eSpark-Backup/stephenlong-acfoutputpcb/README.md

# ACF Output PCB
####  Client Name: Stephen Long Jr.

## Project Requirements
This project involves the PCB layout design for the ACF Output PCBA, a daughter board of the ACF system. The Output PCBA serves as the main I/O interface for DMX and Ethernet signals and includes electrical connections to the system’s external circular connector and a board-to-board interface with the ACF User Interface PCBA via a Bridge PCBA. The core features and selected parts information is mentioned below:
- Connectors
    - DMX Input Connector:
        - Part Number: NC5MBV-B (5-pin male XLR)
    - DMX Output Connector:
        - Part Number: NC5FBV-B (5-pin female XLR)
    - DMX input/output circuitry
        - Add the SM712 very close to the "outside world" connector for the DMX. It is a very basic TVS protection in case the customer would connect a wrong cable to the line. This TVS will protect the electronics. I think it is the best place for the protections.


- Ethernet Connectors x 2
    - Part Number: NE8FBV-C5-LED (EtherCON RJ45 receptacles with integrated light pipes)
        - Please add those resistors and capacitors next to the ethernet connectors.
        - And also add a TVS protection on each RS485 differential pair, we usually use the SM712
        - Reference design for Ethernet and TVS Datasheet is pushed to docs (to be considered as a suggestion and reference only)
- Board to Board Data x 2
    - Part Number: SSW-110-02-G-D-RA-N Mfr.: Samtec
    - User Interface PCBA for reference:  

- LED Indicators for Ethernet
    - Each RJ45 port requires:
        - Left LED (Green): Indicates active link
        - Right LED (Yellow): Indicates data activity
    - LEDs will be SMD-mounted under the NE8FBV-C5-LED light pipe window.
        - Placement and routing shall follow manufacturer light pipe guidelines.
- Board-to-Board Interface (to Bridge PCBA)
    - Include a board-to-board header to connect with the Bridge PCBA.

- Circular Connector Output Header
    - 8-pin output header for external panel connection:
        - 2x 24V lines (14AWG)
        - 2x GND (14AWG)
        - 4x differential data pair (twisted pair) to panels (26AWG) (total of 8 wires)
        - 8A current capacity for power lines  
  
    - Pinout and mechanical dimensions will be confirmed during layout phase
### Pin Number Reference Photos






**Note:** The new LEDs coming from the W5500 and the "GND_DRIVE" will be the signals for driving the LEDs on the ethernet connections. They are pins 4-5-6 on the J10 connectors. Also mention that the P1LED and P2LED should drive via the "GND_DRIVE" pin (one side to PxLED an the other to "GND_DRIVE".

### Assumptions and Constraints
- The ACF Output PCBA will not contain any microcontrollers or active control logic; it is a passive I/O board.
- All firmware, control logic, and display interfacing is handled by the ACF UI PCBA.
- Mechanical constraints must be confirmed early in the layout process to ensure connector alignment and clearance

### Product Concept Images
