eSpark-Backup/stephenlong-acfoutputpcb/Design-Files/ACF_Out-v2.0/Deliverables/_Renderings/2D_C_View.png

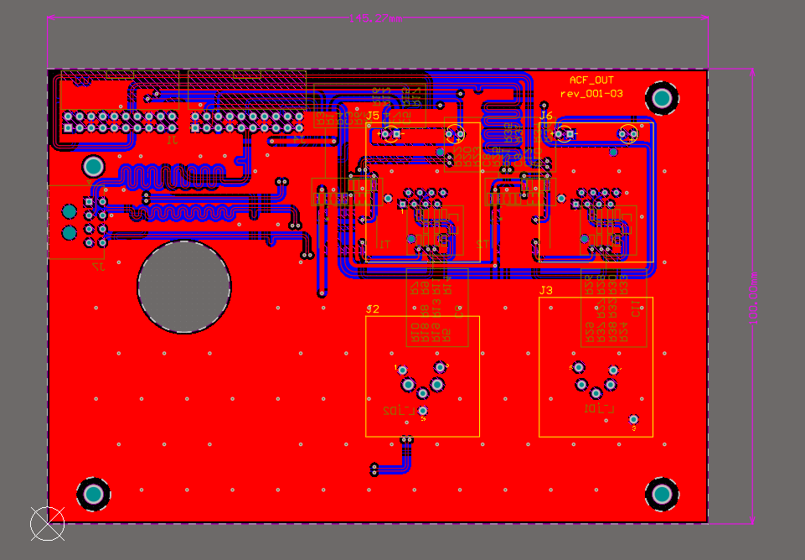
Design-Files/ACF_Out-v2.0/Deliverables/_Renderings/2D_C_View.png
