eSpark-Backup/stephenlong-acfoutputpcb/Design-Files/ACF_Out-v2.0/Deliverables/_Renderings/3D_Isometric_View.png

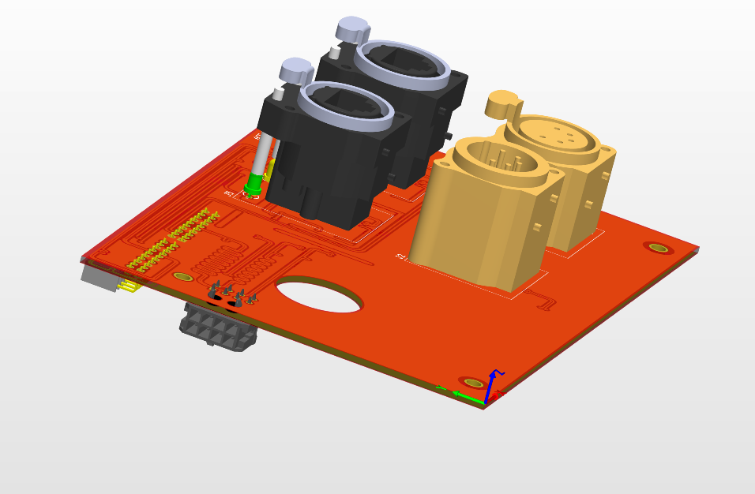
Design-Files/ACF_Out-v2.0/Deliverables/_Renderings/3D_Isometric_View.png
