eSpark-Backup/stephenlong-acfoutputpcb/docs/Client-Files/Reference Materials/Ethernet Reference Schematic.png

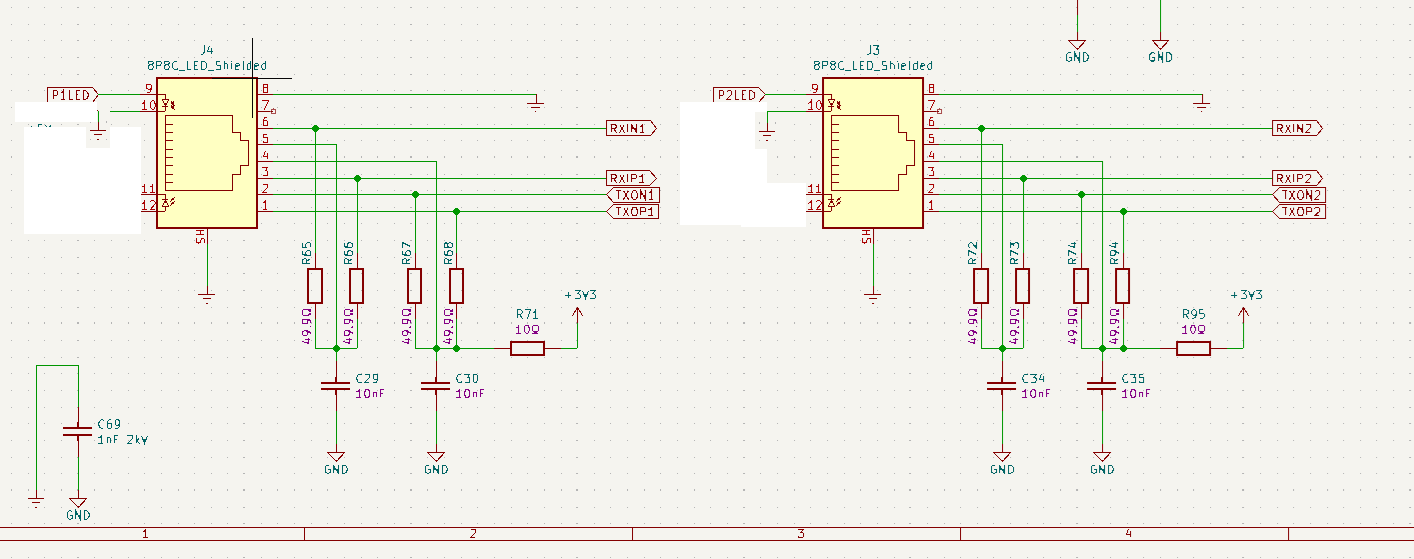
docs/Client-Files/Reference Materials/Ethernet Reference Schematic.png
