eSpark-Backup/stephenlong-acfoutputpcb/Design-Files/ACF_Out-v2.0/Deliverables/_BOM/Client_BOM_ACF_Out-v2.0.xlsx

# | Item Type | Designator | Description | Footprint | Manufacturer Part Number | Manufacturer | Comment | Quantity
1 | Capacitor | C3, C8 | CAP CER 0.022UF 50V X7R 0603 | Cap-0603 | CC0603KRX7R9BB223 | Yageo | 22nF | 2
2 | Capacitor | C4, C5, C9, C10 | 50V 6.8nF X7R ±10% 0603 | Cap-0603 | 0603B682K500NT | FH | 6.8nF | 4
3 | Capacitor | C6, C11 | CAP CER 4700PF 1KV X7R 1206 | Cap-1206 | CC1206KKX7RCBB472 | Yageo | 4.7nF | 2
4 | Capacitor | C7, C12 | CAP CER 10000PF 100V X7R 0603 | Cap-0603 | CC0603KRX7R0BB103 | Yageo | 10nF | 2
5 | Diode | D1, D2 | SOT-23 TVS ROHS | SOT-23 | SM712 | TECH PUBLIC | SM712 | 2
6 | Connectors | J1, J4 | CONN RCPT 20POS 0.1 GOLD PCB R/A | SSW-110-02-G-D-RA-N | SSW-110-02-G-D-RA-N | Samtec | SSW-110-02-G-D-RA-N | 2
7 | Audio / Video Connectors | J2 | XLR Connectors 5P M RECEPT B SER PCBV PN 1 GRD SEP BK | NC5MBV-B | NC5MBV-B | Neutrik | NC5MBV-B | 1
8 | Connectors | J3 | XLR Connectors 5P M RECEPT B SER PCBV PN 1 GRD SEP BK | NC5FBV-B | NC5FBV-B | Neutrik | NC5FBV-B | 1
9 | Modular / Ethernet Connectors | J5, J6 | Modular Connectors / Ethernet Connectors RECP CAT5e B series PCBV, 24mm FP to PCB | NE8FBV-C5-LED | NE8FBV-C5-LED | Neutrik | NE8FBV-C5-LED | 2
10 | Headers and Wire Housings | J7 | CONN HEADER R/A 8POS 3MM | 430450800 | 43045-0800 | Molex | 43045-0800 | 1
11 | LED | LED1, LED2 | 515nm~525nm -30℃~+85℃ Emerald 30° 200mW Plugin,D=3mm Light Emitting Diodes (LED) ROHS | TH LED 3mm_ | NFD3401UGD | Foshan NationStar Optoelectronics | Emerald | 2
12 | LED | LED3, LED4 | 585nm~595nm -30℃~+85℃ Yellow 30° 200mW Plugin,D=3mm Light Emitting Diodes (LED) ROHS | TH LED Yellow 3MM | NFD3401UYD | Foshan NationStar Optoelectronics | Yellow | 2
13 | Resistor | R1, R2, R3, R7, R8, R9, R11, R13, R14, R20, R21, R22, R26, R27, R28, R30, R32, R33 | RES 49.9 OHM 1% 1/10W 0603 | Res-0603 | RC0603FR-0749R9L | Yageo | 49.9R | 18
14 | Resistor | R4, R6, R12, R15, R23, R25, R31, R34 | RES SMD 0603 33 Ohm 1% 1/10W | Res-0603 | RC0603FR-0733RL | Yageo | 33R | 8
15 | Resistor | R5, R10, R16, R17, R24, R29, R35, R36 | RES 75 OHM 1% 1/10W 0603 | Res-0603 | RC0603FR-0775RL | Yageo | 75R | 8
16 | Resistor | R18, R19, R37, R38 | RES SMD 150OHM 1/10W 0603 | Res-0603 | RC0603FR-07150RL | Yageo | 150R | 4
17 | RJ45 Transformer | T1, T2 | XFRMR MAGNETIC 1PORT 1:1 10/100 | H1102NLT | H1102NL | Pulse | H1102NL | 2
