eSpark-Backup/stephenlong-acfoutputpcb/docs/Client-Files/Reference Materials/TVS Datasheet.png

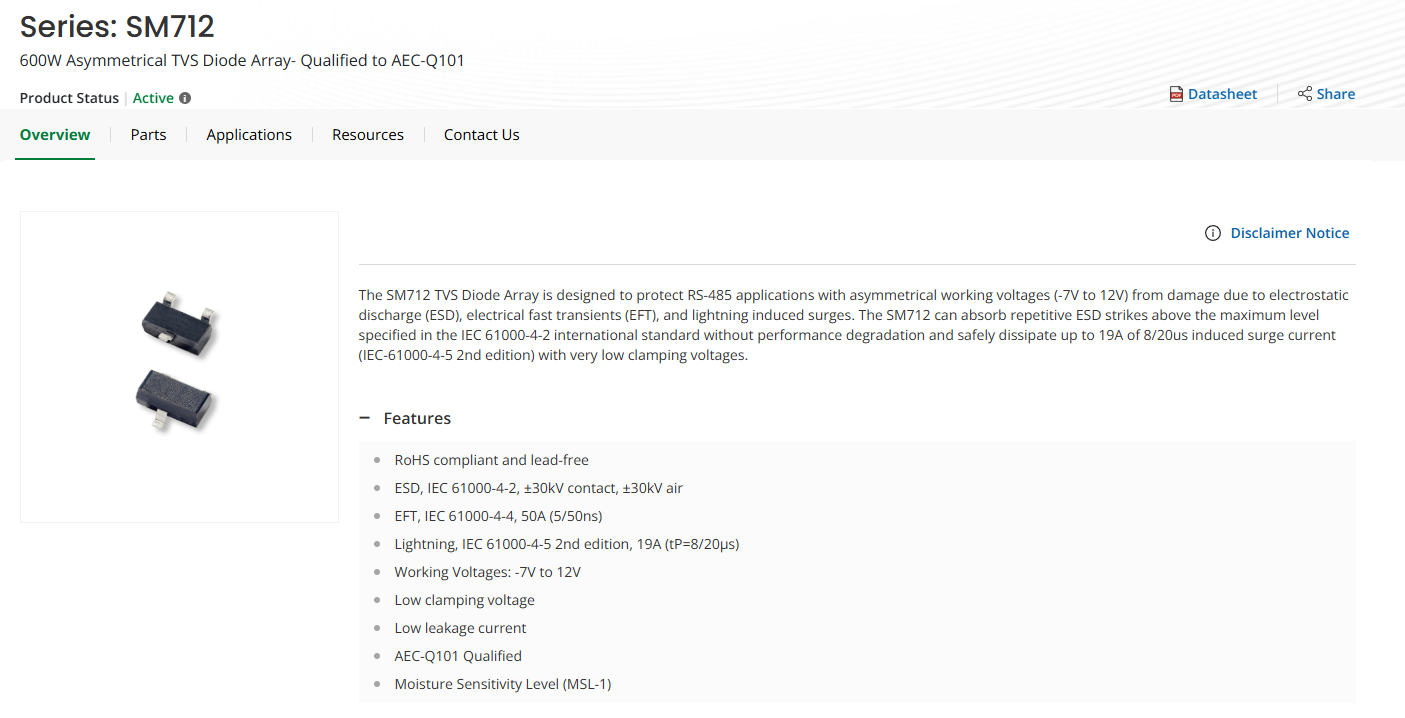
docs/Client-Files/Reference Materials/TVS Datasheet.png
