eSpark-Backup/stephenlong-acfoutputpcb/docs/Client-Files/Reference Materials/ACF-Output-PCB-03.DXF

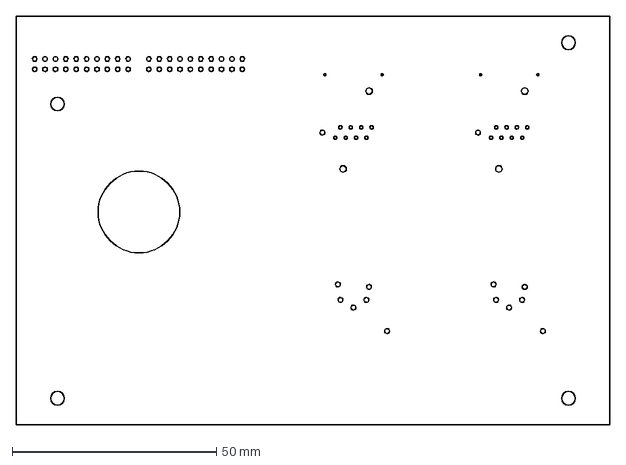
[picture p10: CAD file, 2025-04-25]
docs/Client-Files/Reference Materials/ACF-Output-PCB-03.DXF
145.3 x 100.0 mm
