eSpark-Backup/stephenlong-acfoutputpcb/docs/Client-Files/Reference Materials/ACF-Output-PCBA-03.STEP

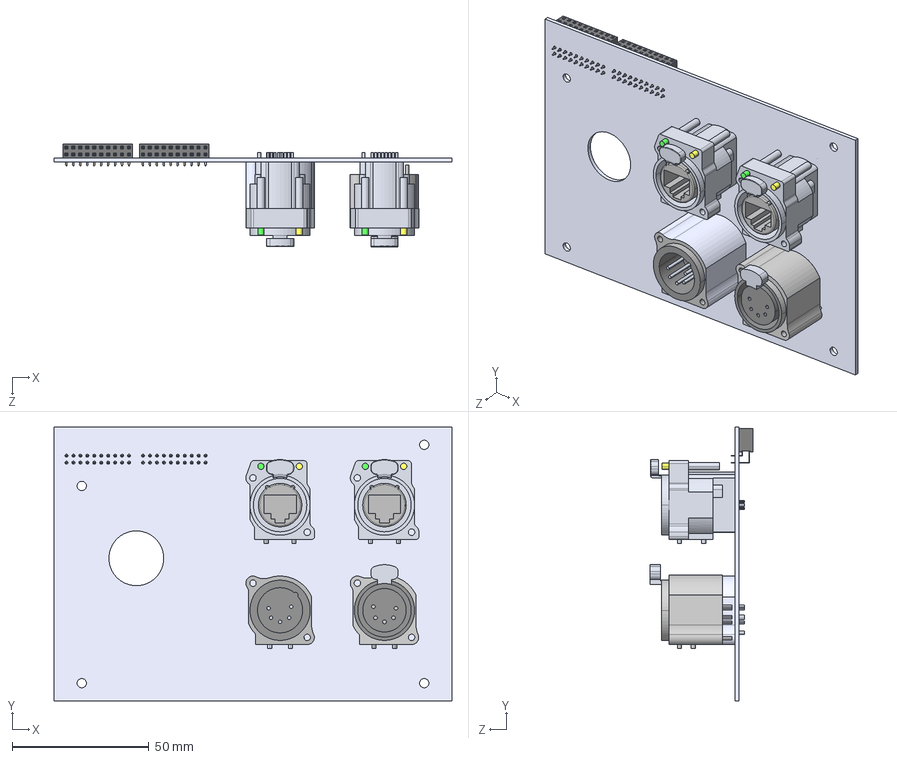
[picture p11: CAD file, 2025-04-25]
docs/Client-Files/Reference Materials/ACF-Output-PCBA-03.STEP
145.3 x 100.0 x 37.5 mm
ACF-Output-PCB-03
d-ne8fbv-c5-led x 2
nc5mbv-1
NC5FBV
PinSocket_2x10_P2.54mm_Horizontal x 2
