eSpark-Backup/stephenlong-acfoutputpcb/Design-Files/ACF_Out-v1.0/Deliverables/_Supporting Files/ACF_Out-v2.0.step

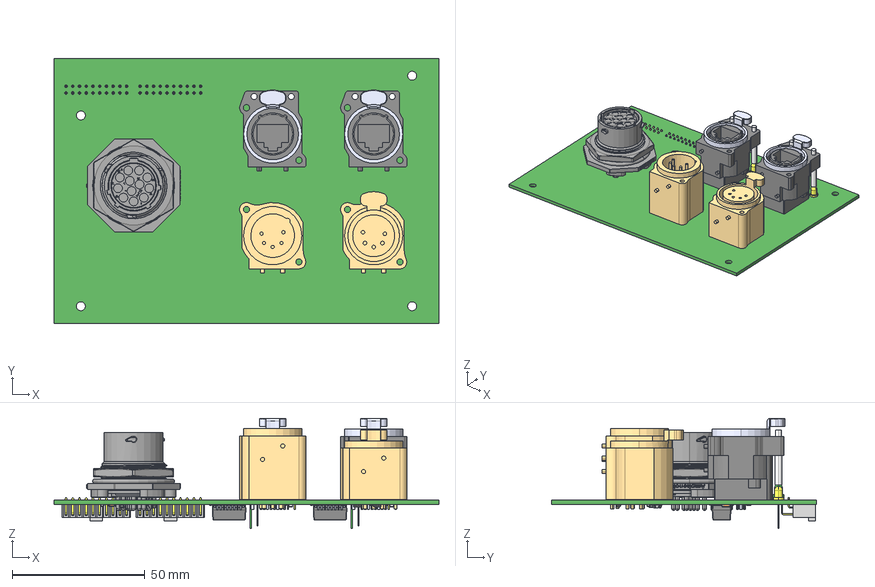
[picture p12: CAD file, 2025-04-30, an earlier design]
Design-Files/ACF_Out-v1.0/Deliverables/_Supporting Files/ACF_Out-v2.0.step
145.3 x 100.0 x 41.6 mm
H1102NLT x 2
User Library-RESC1608X05N x 38
User Library-CAPC1608X09 x 8
User Library-1206 SMD Capacitor x 2
T1SSW-110-02-G-D-RA-N x 2
P2SSW-110-02-G-D-RA x 2
User Library-LED 3 mm_RGB65280 x 2
VLS252012HBX-100M
RTS714ND12S0332_RGB6710886
NE8FBV-C5-LED_NE8FBV-C5-LED x 2
3-D NC5FBV
nc5mbv-1
CircuitWorks-SOT-23 x 2
User Library-0805 SMD Capacitor x 2
