eSpark-Backup/stephenlong-acfoutputpcb/(list of files, cad)

Other CAD files:
Design-Files/ACF_Out-v1.0/Deliverables/_Supporting Files/ACF_Out-v2.0..DWG
Design-Files/ACF_Out-v1.0/Deliverables/_Supporting Files/ACF_Out-v2.0.DXF
Design-Files/ACF_Out-v2.0/Deliverables/_Supporting Files/ACF_Out-v2.0..DWG
Design-Files/ACF_Out-v2.0/Deliverables/_Supporting Files/ACF_Out-v2.0.DXF
