eSpark-Backup/stephenlong-acfoutputpcb/Design-Files/ACF_Out-v2.0/ACF_Out-v2.0.pdf

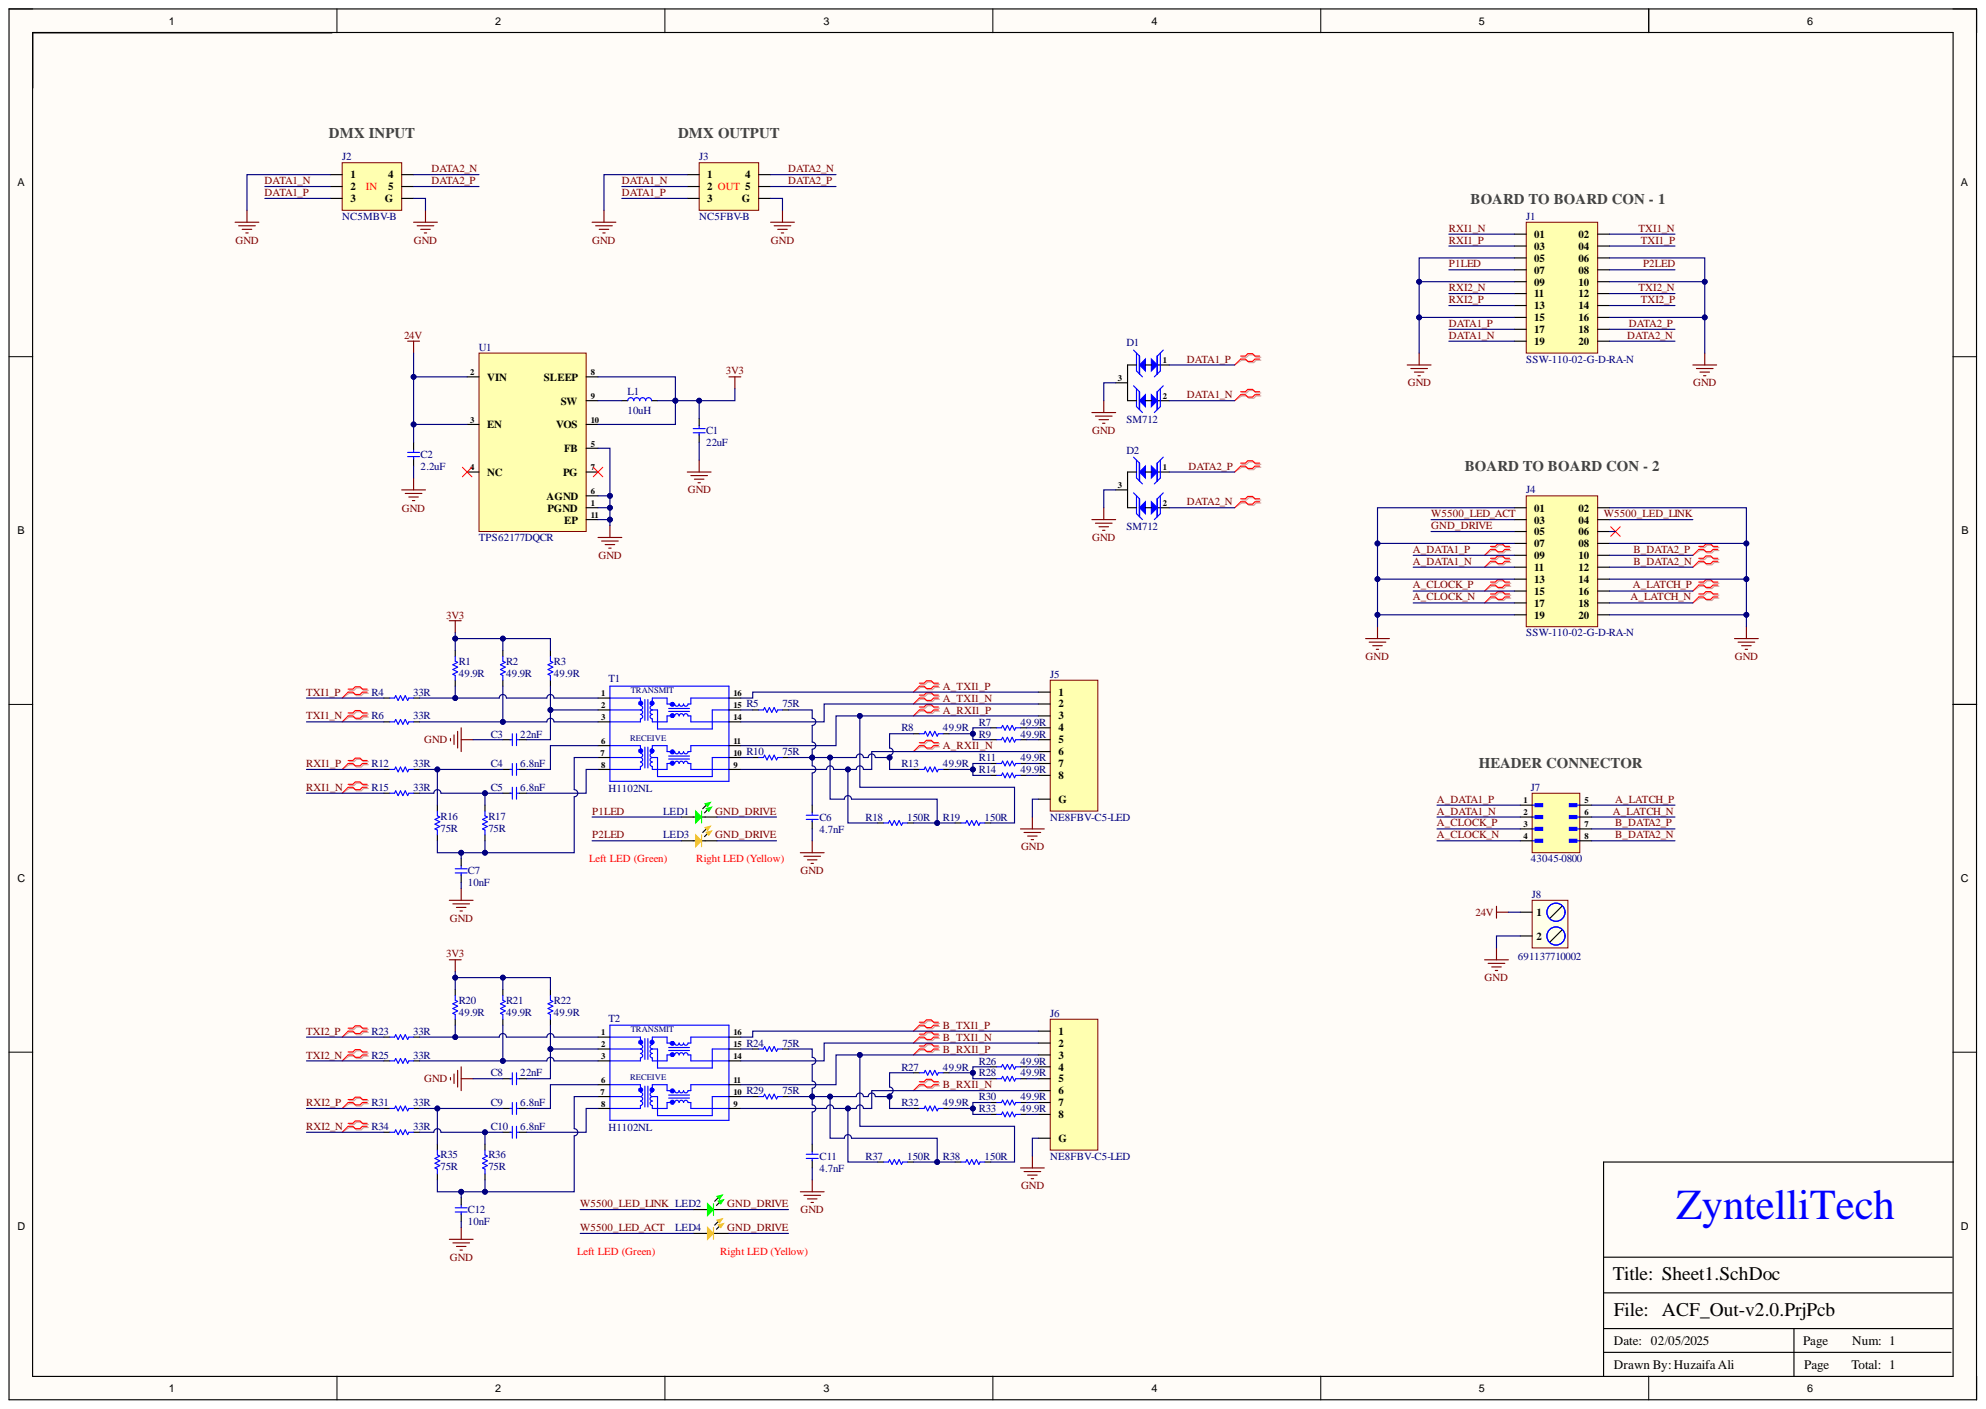
[picture p13: page 1]

P 1 LED | P 2 LED

D ATA 1 _P D ATA 1 _N | D ATA 2_P D ATA 2_N

TRA N S MIT RECEIV | 6 A _ T X I 1 _N

Date: 0 2 /0 5 /2 0 2 5 | Pag e N u m : 11

D raw n B y : H uzai fa A l i | Pag e To tal :

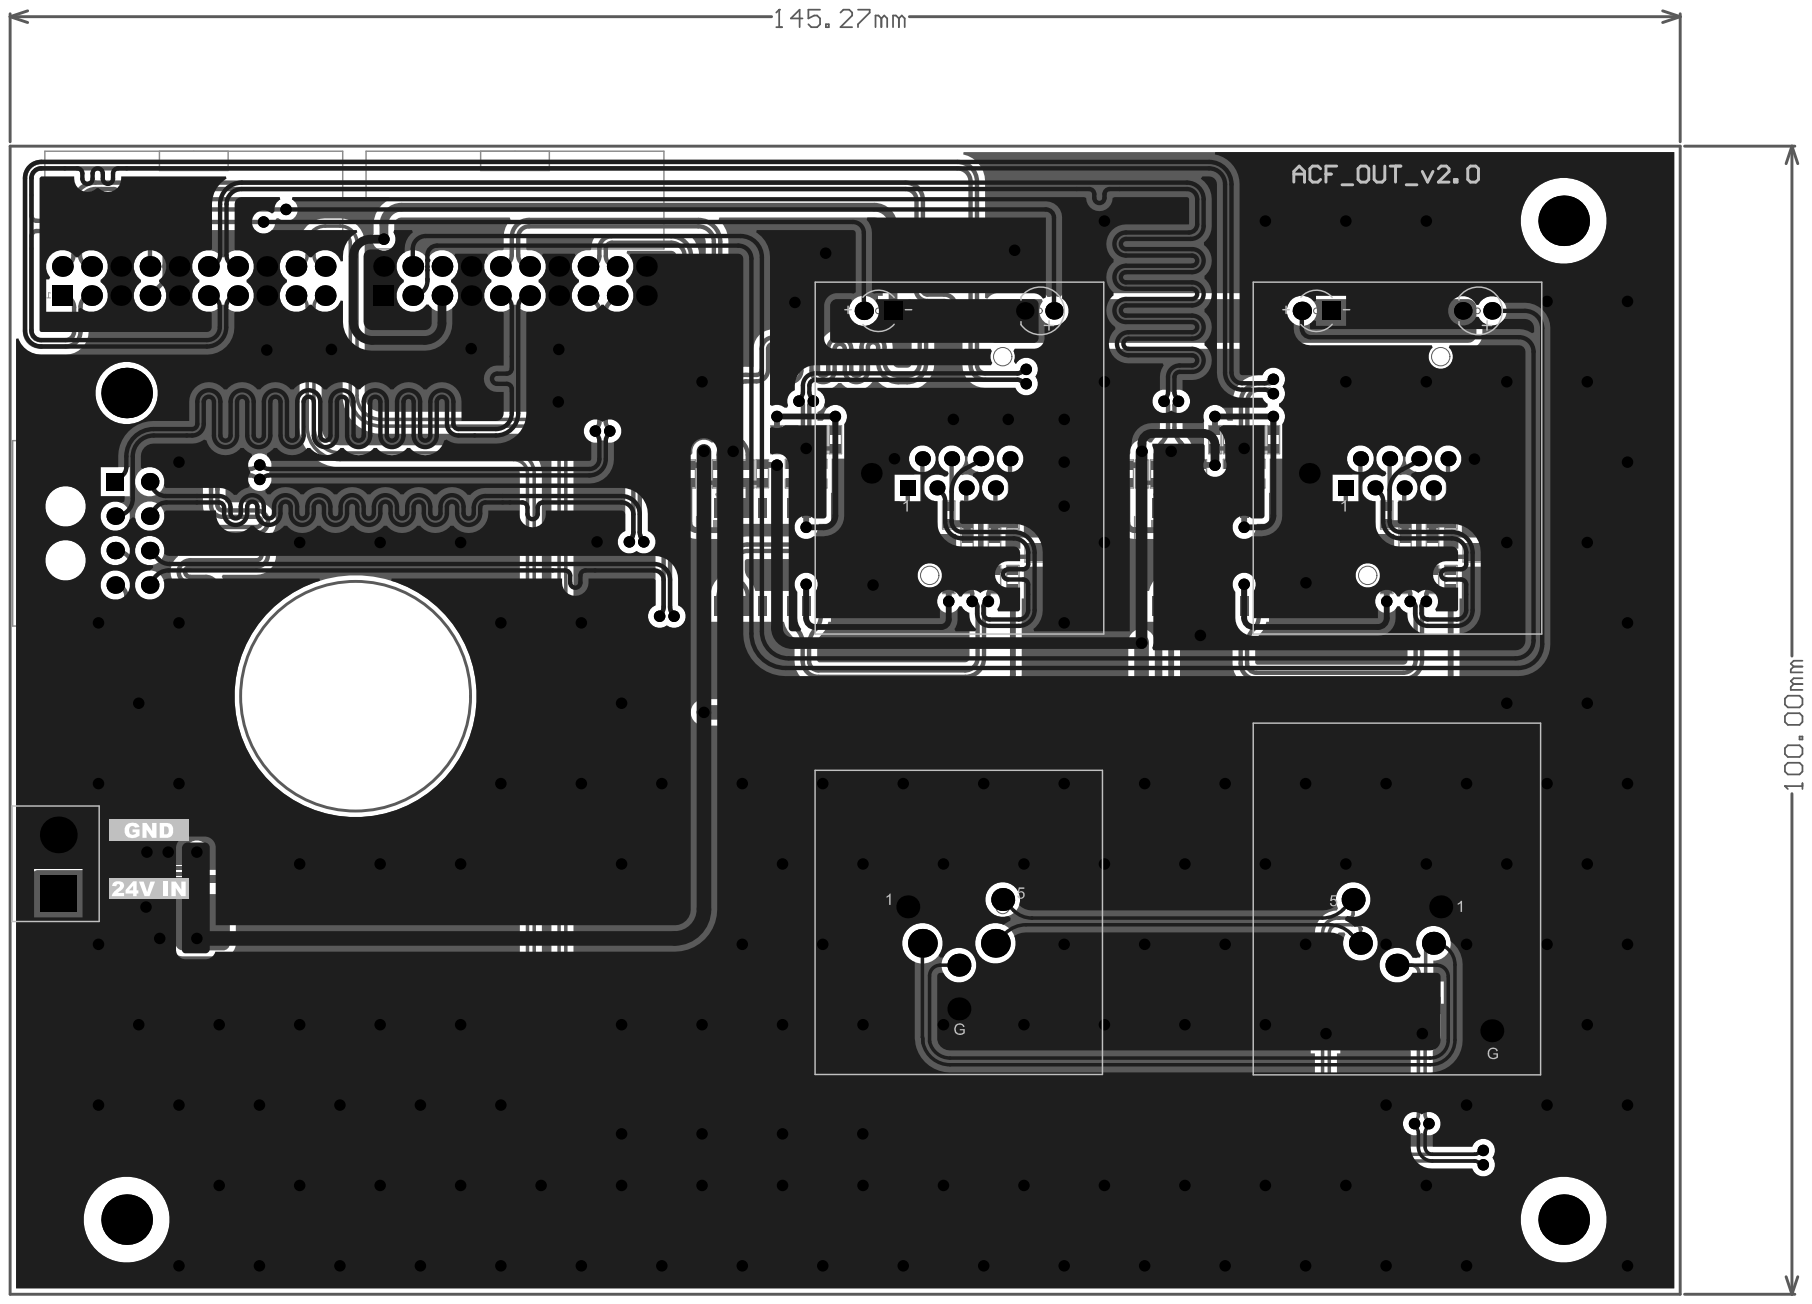
[picture p14: page 2]
