eSpark-Backup/stephenlong-acfoutputpcb/Design-Files/ACF_Out-v2.0/Deliverables/_Schematics/ACF_Out-v2.0.pdf

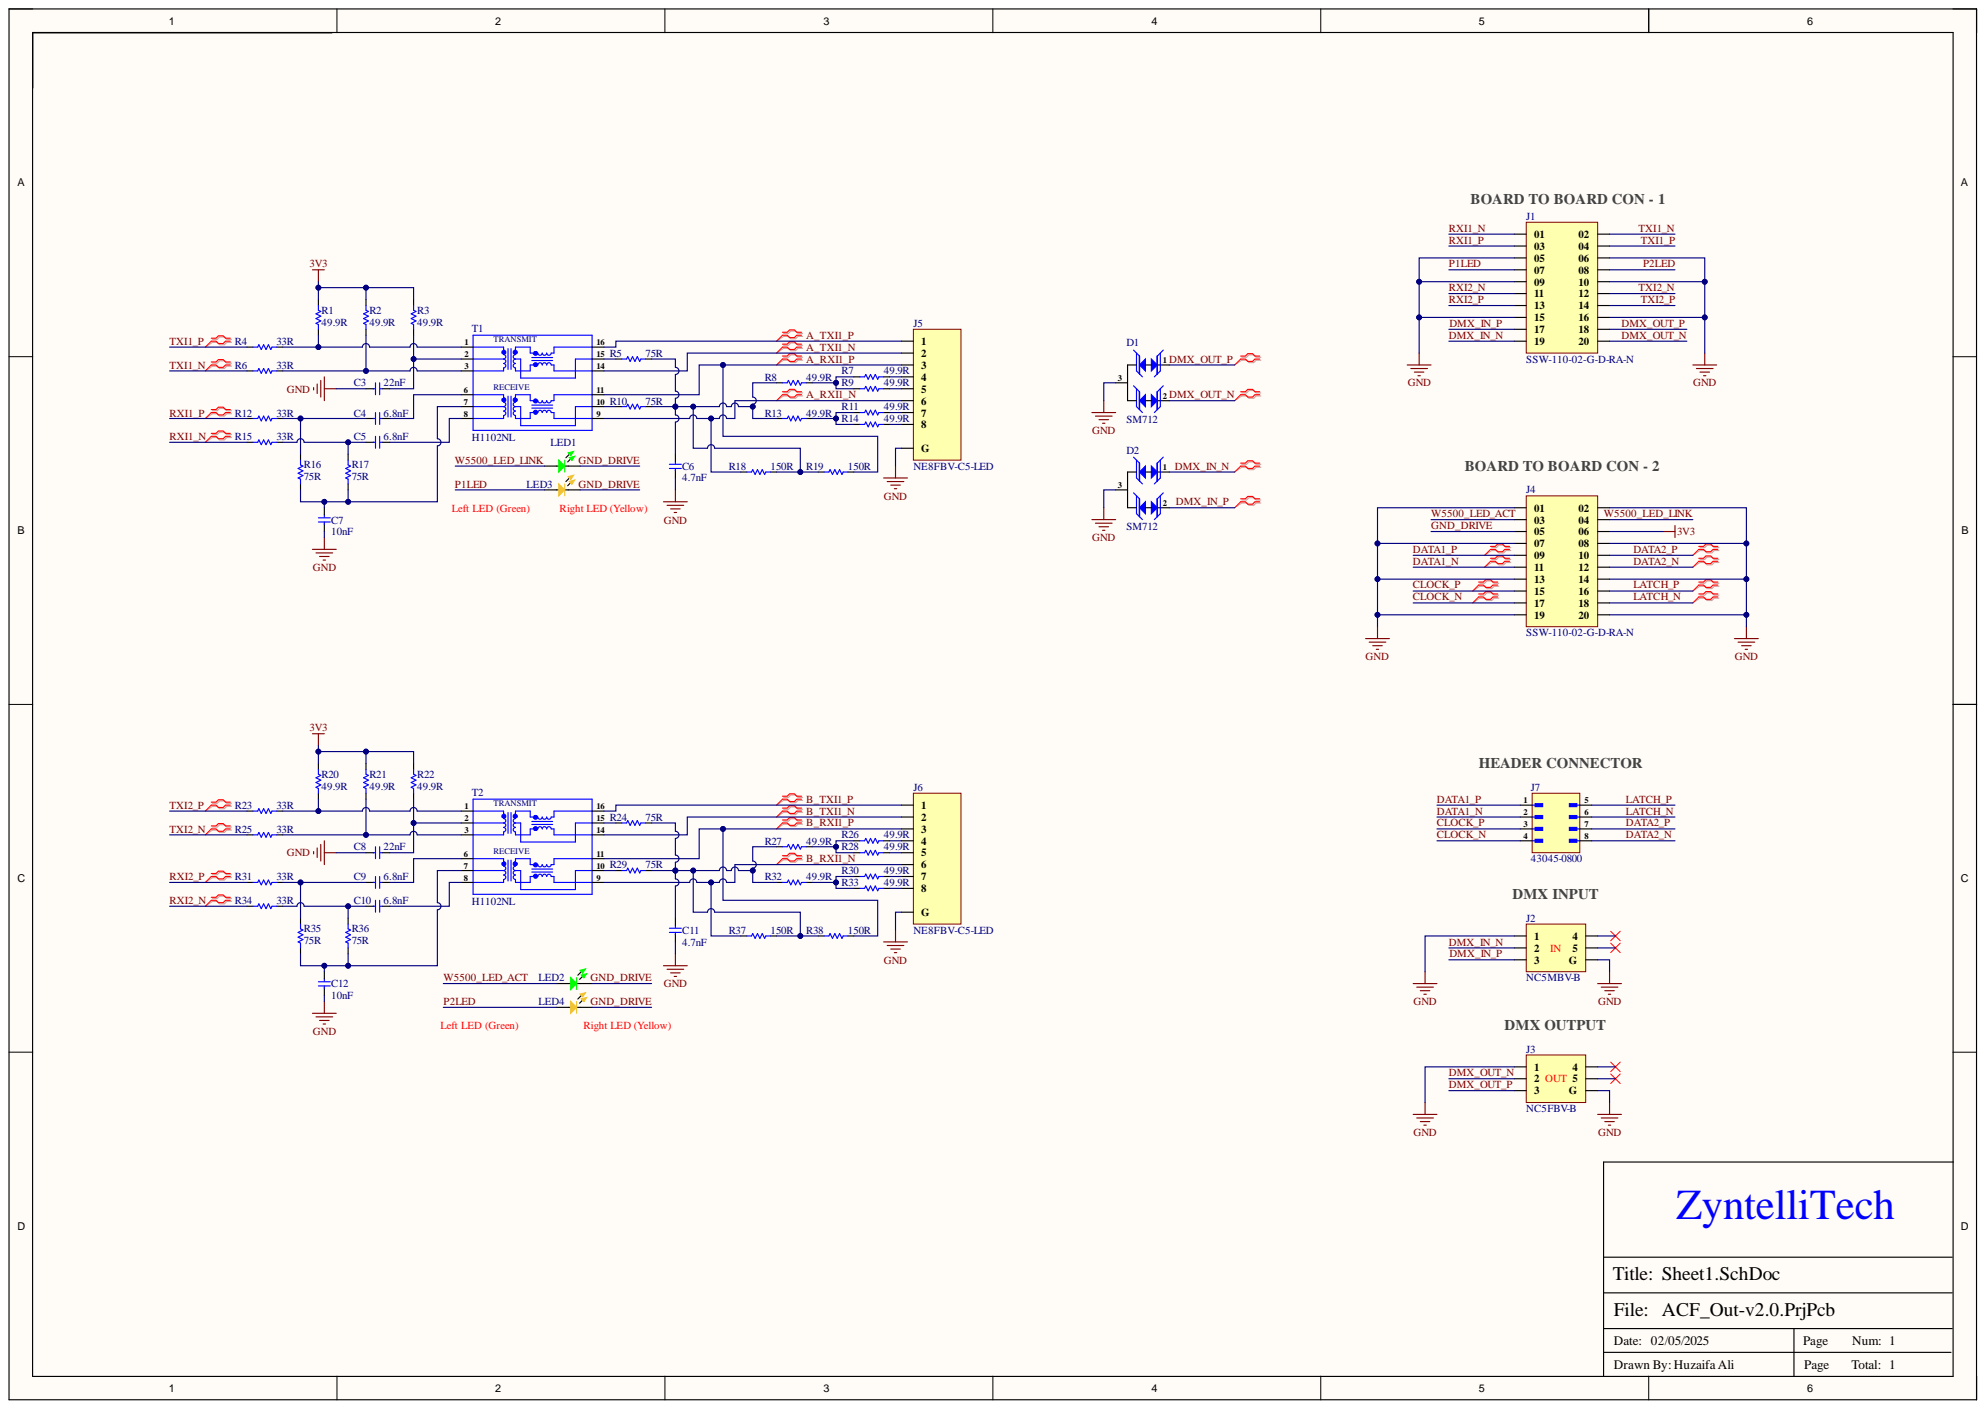
[picture p15: page 1]

DMX _ IN_P DMX _ IN_N | DMX _ O UT_P DMX _ O UT_N

TRA N S MIT RECEIV | 6 A _ T X I 1 _N

Date: 0 2 /0 5 /2 0 2 5 | Pag e N u m : 11

D raw n B y : H uzai fa A l i | Pag e To tal :

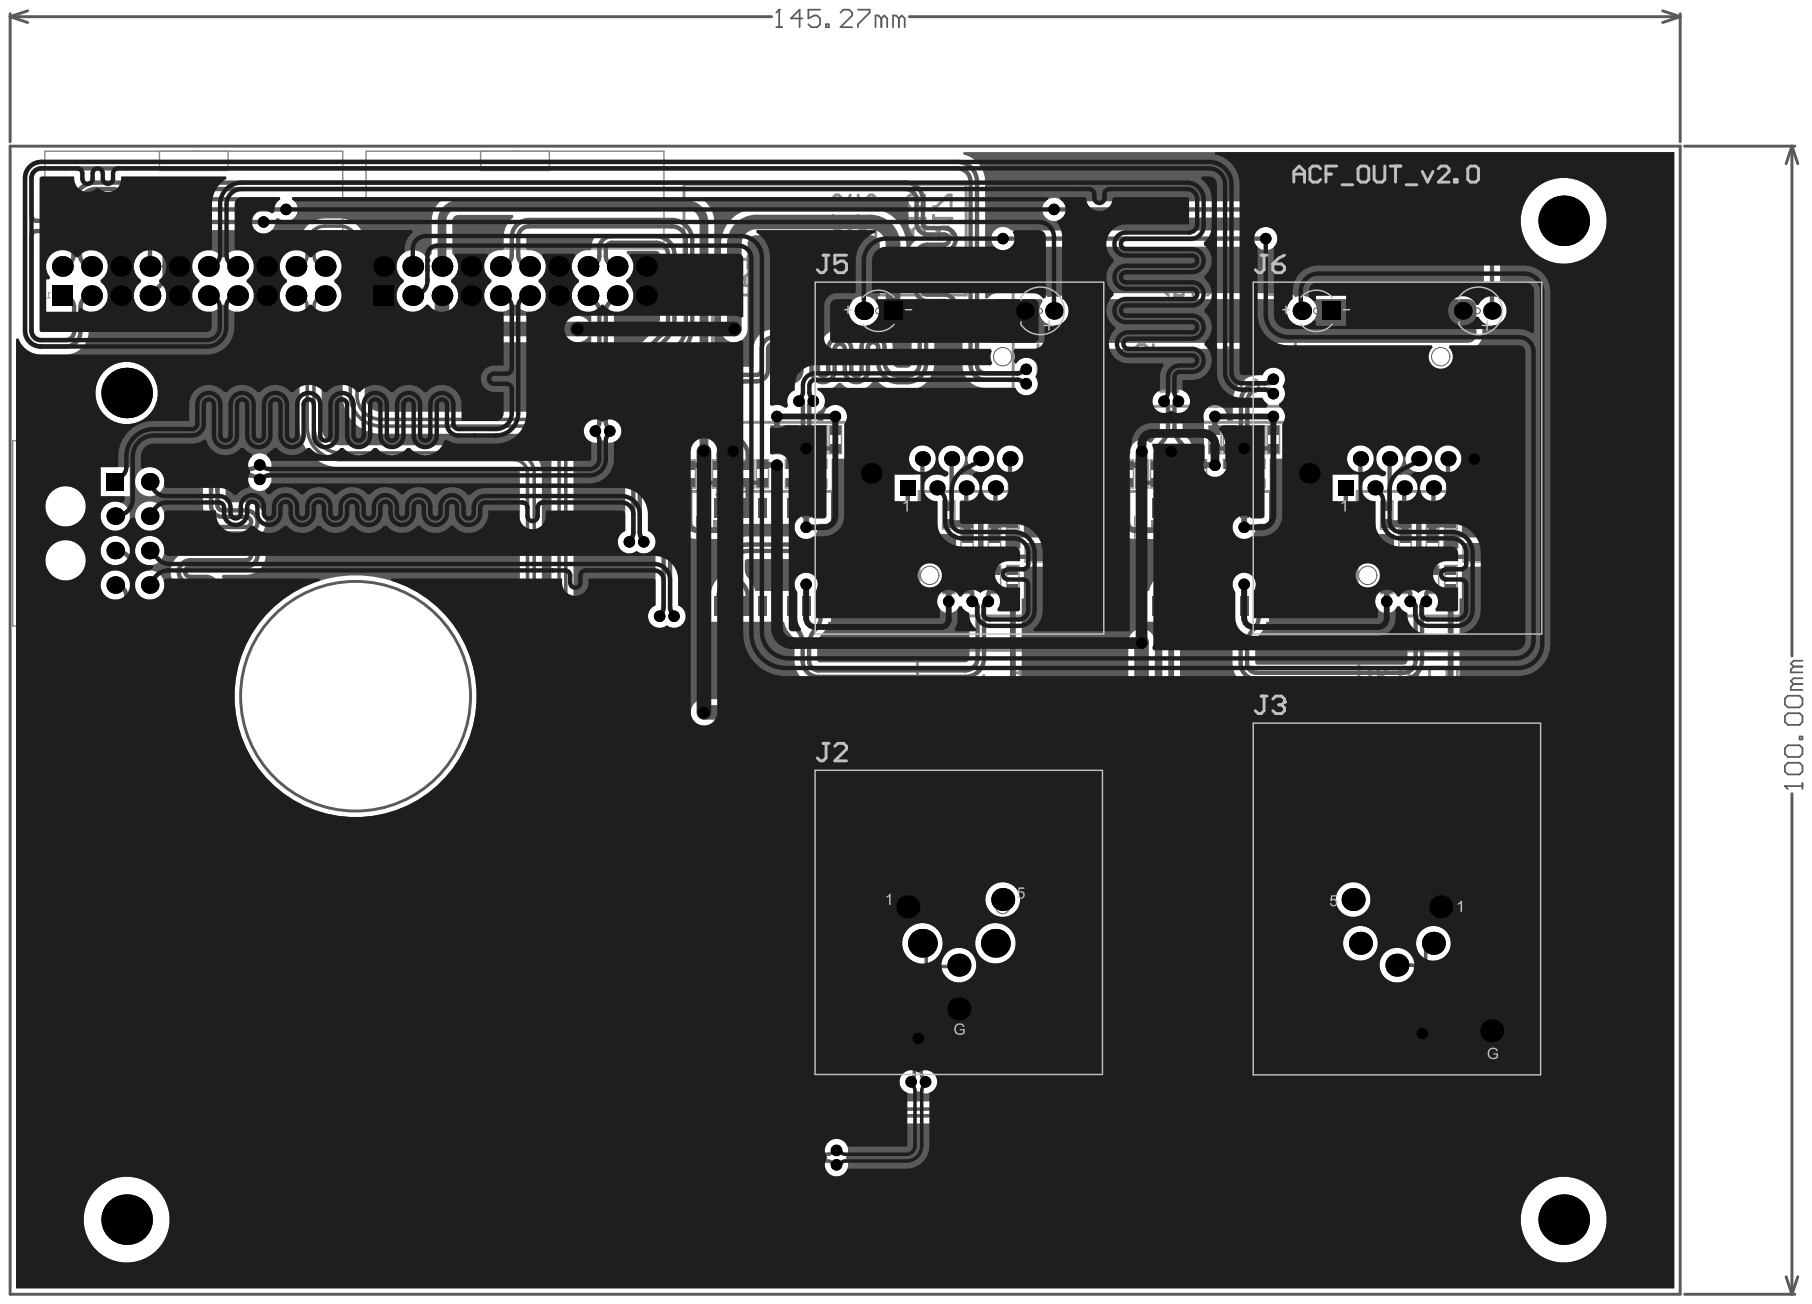
[picture p16: page 2]
