eSpark-Backup/stephenlong-acfoutputpcb/Design-Files/ACF_Out-v1.0/Schematic/ACF_Out-v2.0.pdf

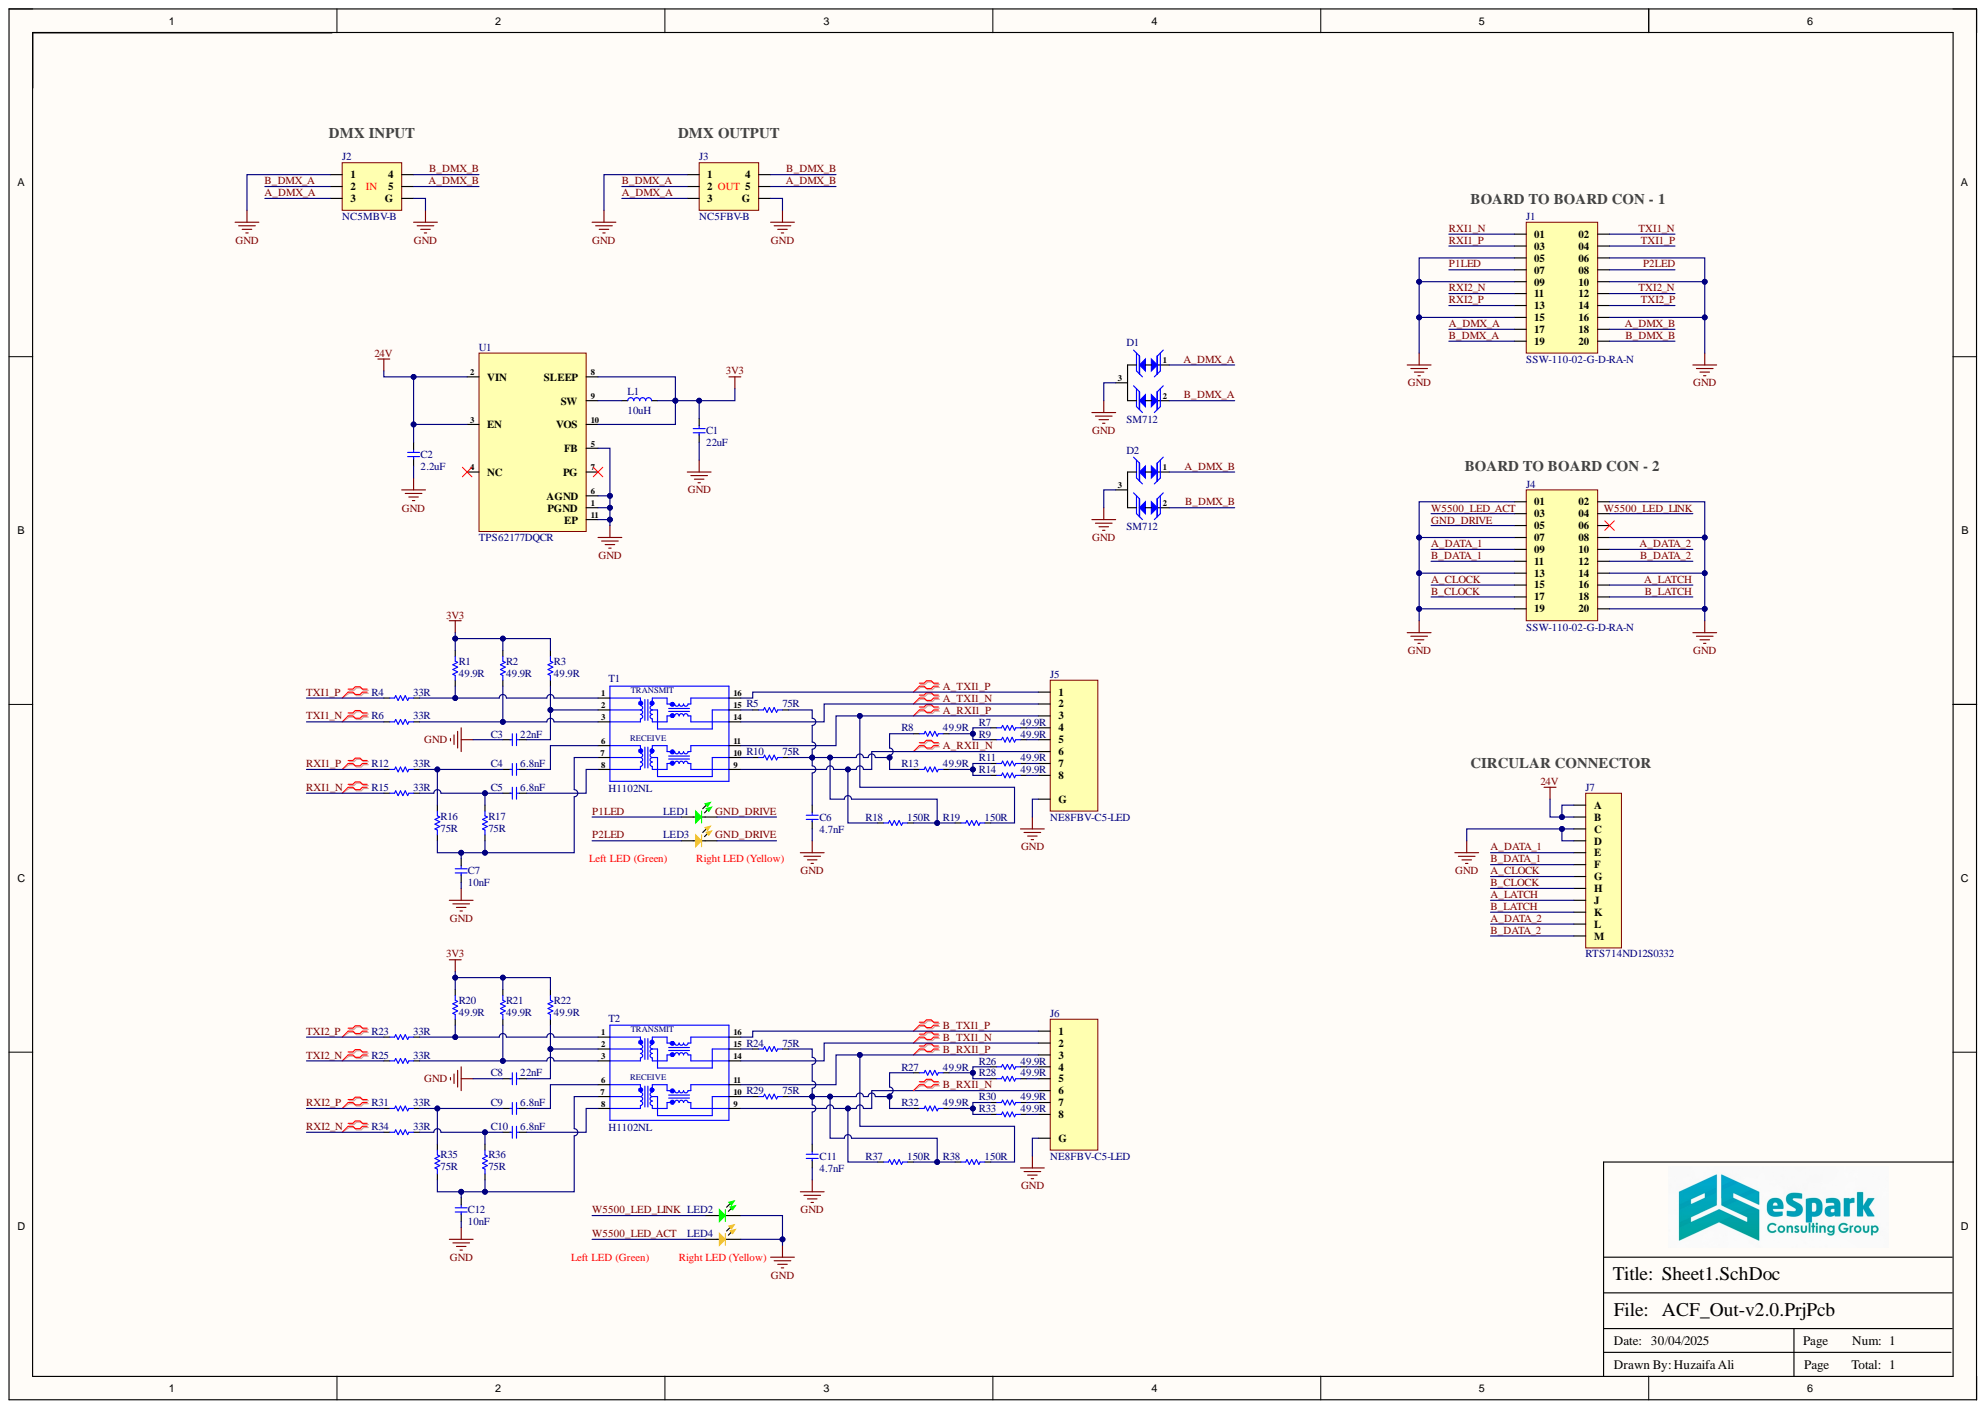
[picture p17: page 1]

P 1 LED | P 2 LED

A _ D ATA_ 1 B _ D ATA_ 1 | A _ D ATA_ 2 B _ D ATA_ 2

A _ C L O C K B _ C L O C K | A _ LAT C H B _ LAT C H

TRA N S MIT RECEIV | 6 A _ T X I 1 _N

Date: 3 0 /0 4/2 0 2 5 | Pag e N u m : 11

D raw n B y : H uzai fa A l i | Pag e To tal :

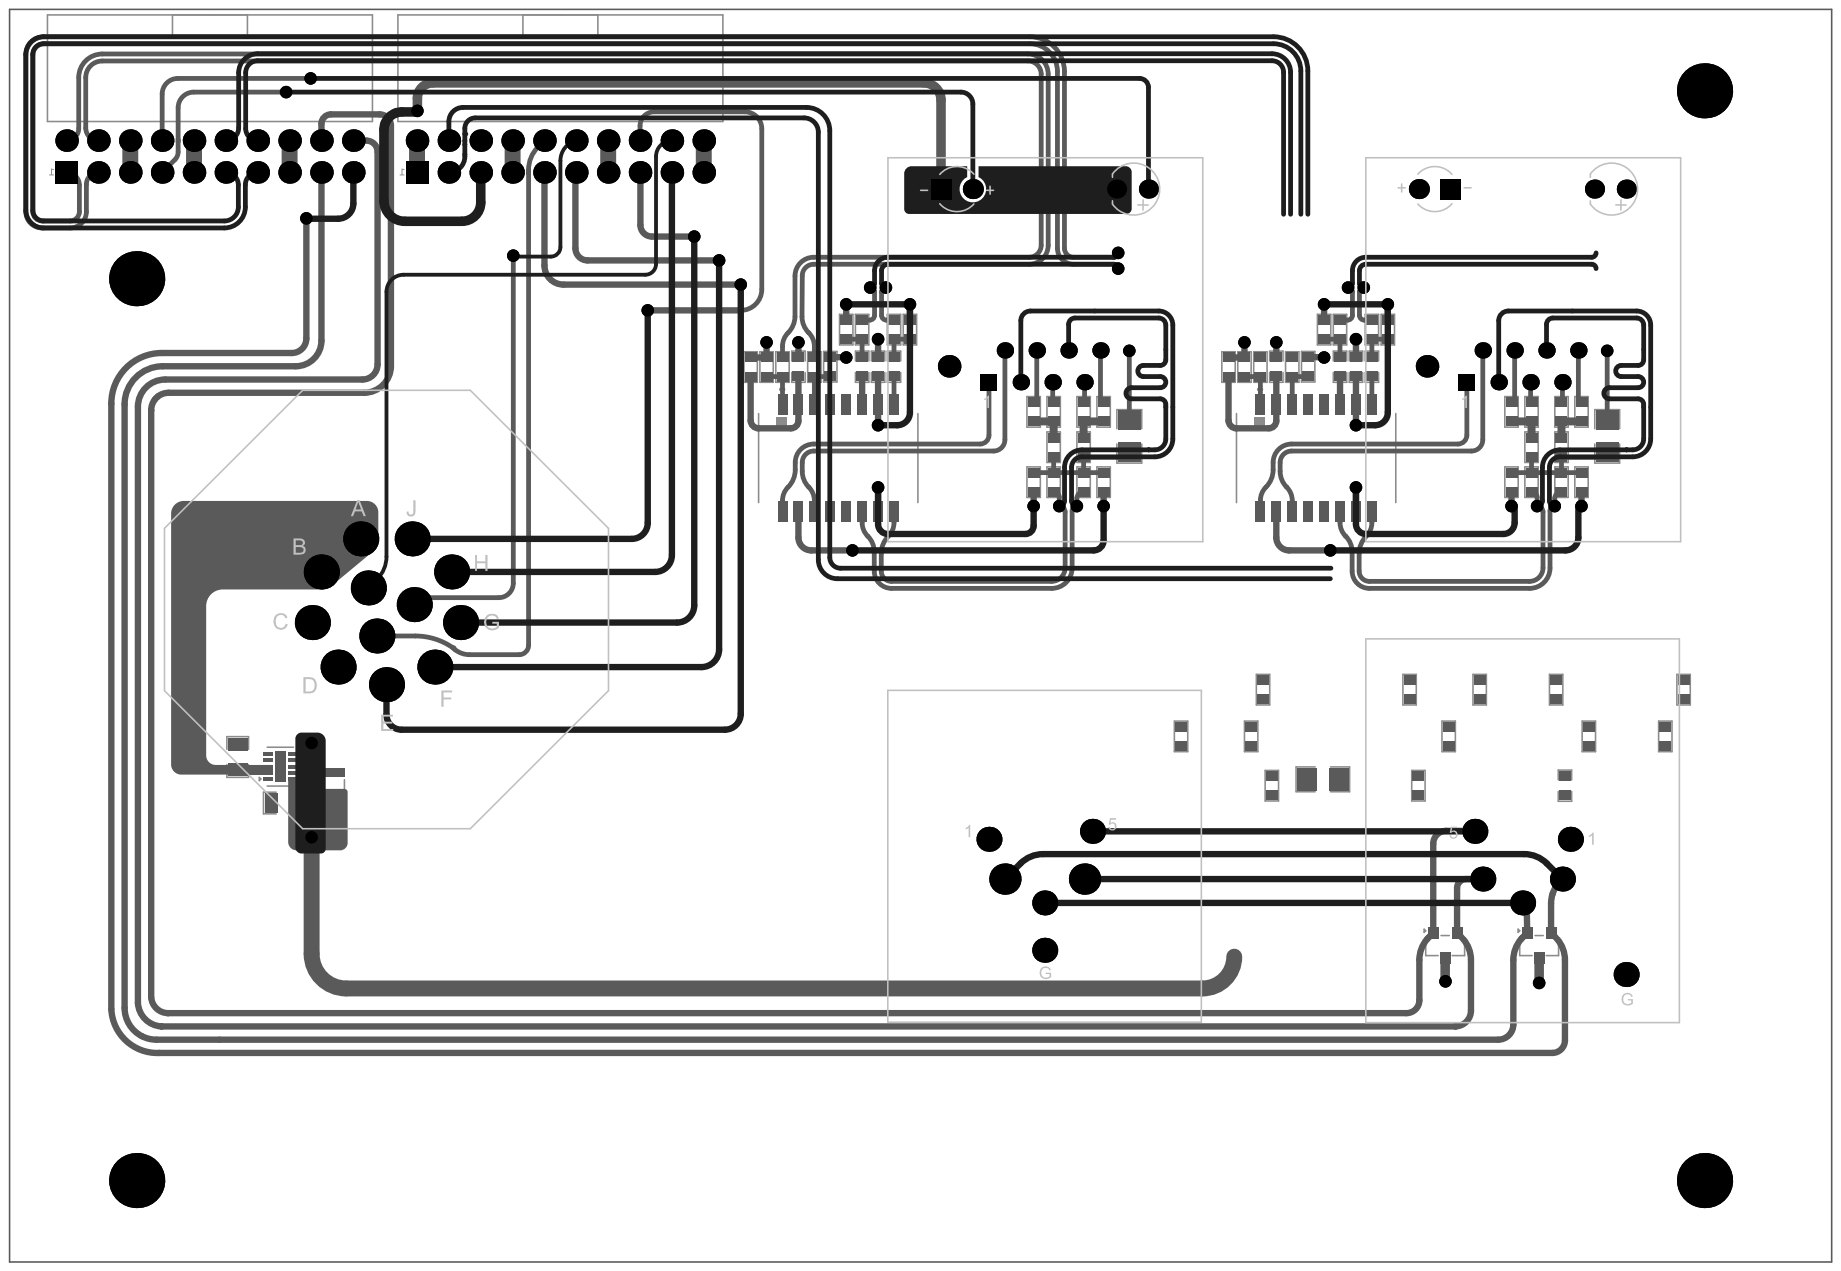
[picture p18: page 2]
