eSpark-Backup/stephenlong-acfoutputpcb/Design-Files/ACF_Out-v1.0/ACF_Out-v2.0.pdf

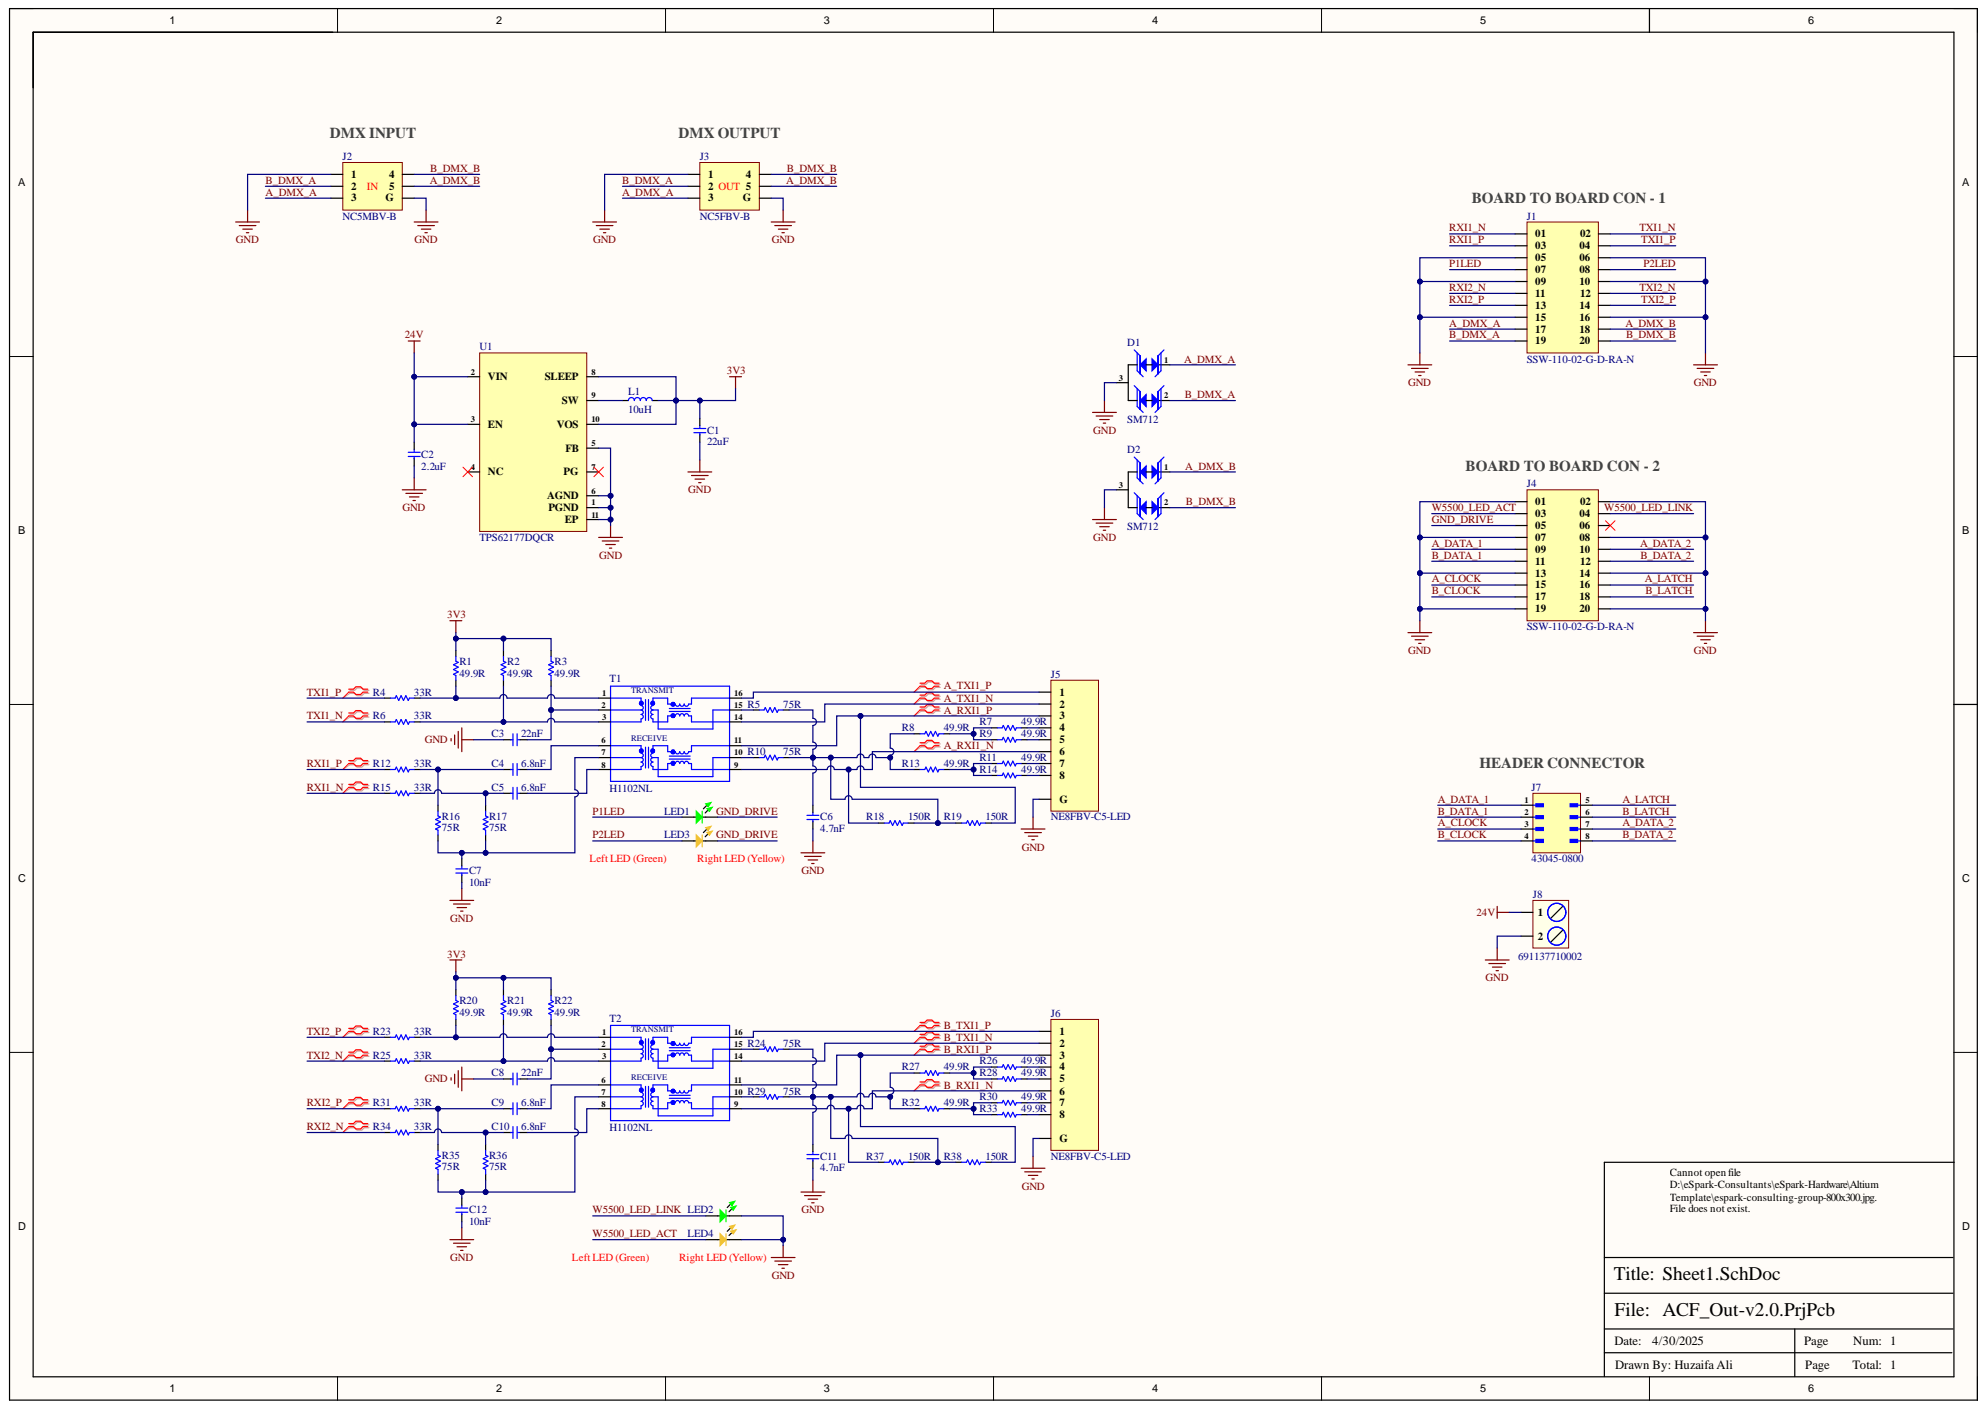
[picture p19: page 1]

RXI2_ N RXI2_ P | TXI2_ N TXI2_ P

A_DMX_ A B_DMX_ A | A_DMX_ B B_DMX_ B

A_CLOC K B_CLOC K | A_LATC H B_LATC H

TRANS M I T C E | R5 75R A_TXI1_ N 15

123678 | 15 | R24 75R B_RXI1_ P

TRANS M I T C E | B_TXI1_ N

RE IVE | 1411 | R26 R28 | 49. | 9 R 9

R29 75R 109 | B_RXI1_ N

Can
D:\eSpark-Consultan
Template\espark-consulting-grou
File does

Date : 4/3 0/2 0 2 5 | P a g e Nu m : 11

Drawn By: Hu z aifa Ali | P a g e T ota l :

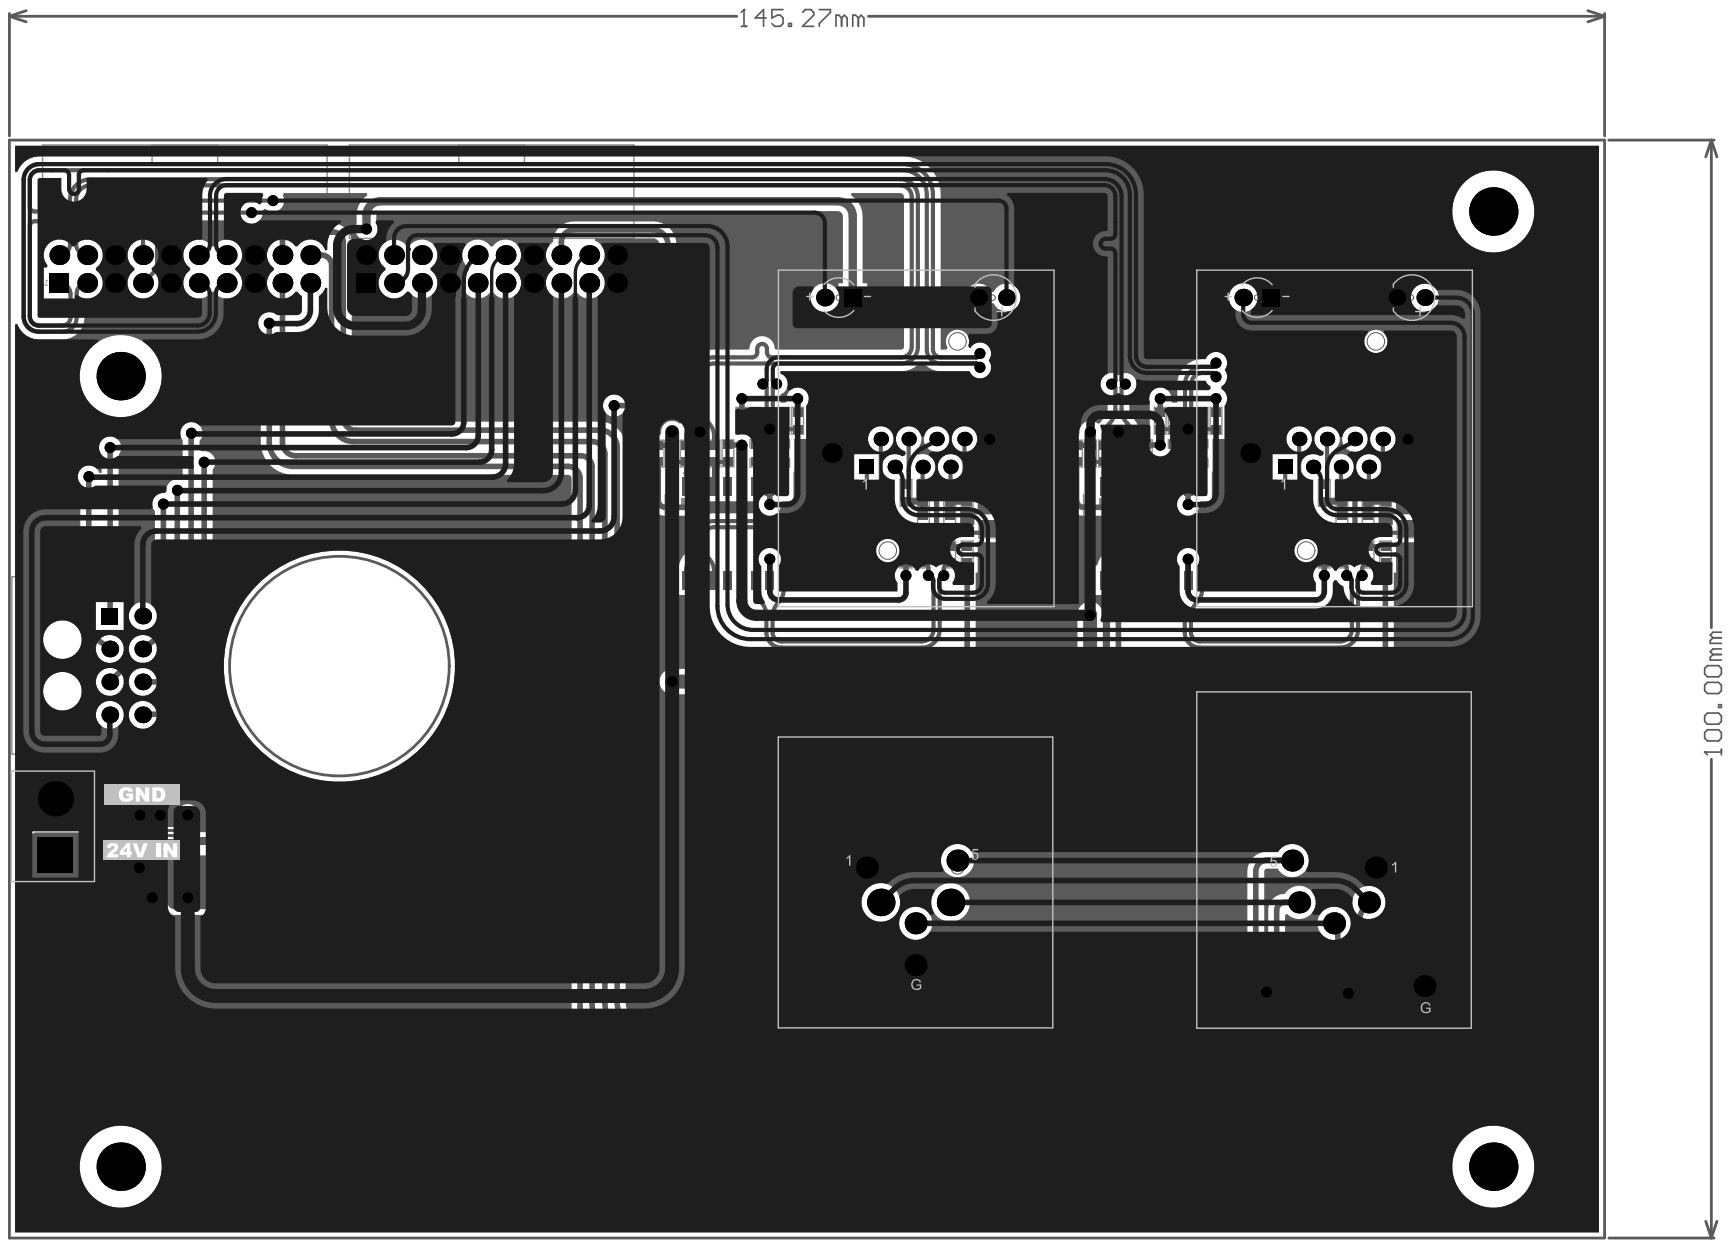
[picture p20: page 2]
