eSpark-Backup/stephenlong-acfoutputpcb/(list of files, drawings)

Other design files:
Design-Files/ACF_Out-v1.0/ACF_Out-v1.0.PrjPcb
Design-Files/ACF_Out-v1.0/ACF_Out-v2.0.PcbDoc
Design-Files/ACF_Out-v1.0/ACF_Out-v2.0.PrjPcb
Design-Files/ACF_Out-v1.0/Sheet1.SchDoc
Design-Files/ACF_Out-v2.0/ACF_Out-v2.0.PcbDoc
Design-Files/ACF_Out-v2.0/ACF_Out-v2.0.PrjPcb
Design-Files/ACF_Out-v2.0/Sheet1.SchDoc
