eSpark-Backup/stephenlong-acfoutputpcb/(commit log)

2025-04-29 #1 magnetics added
2025-04-29 #1 PCB in Progress
2025-04-30 #1 magnetic added in Schematic
2025-04-30 #1 Client BOM added.
2025-05-05 #1 Thermal Relief added in PCB and deliverables generated
